LS404-123/STEAM/artifacts/mode2-motor-board/chip-inspection.png

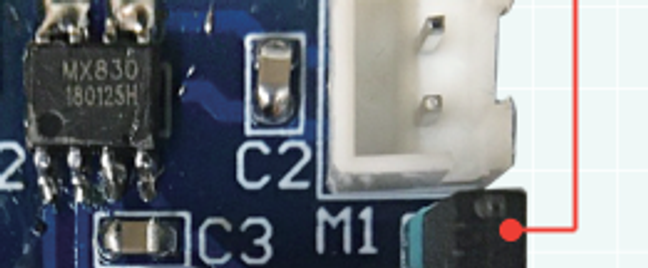
artifacts/mode2-motor-board/chip-inspection.png
