LS404-123/STEAM/artifacts/mode2-motor-board/kicad-rev-h/sources/S0-SS12D10G5-user.png

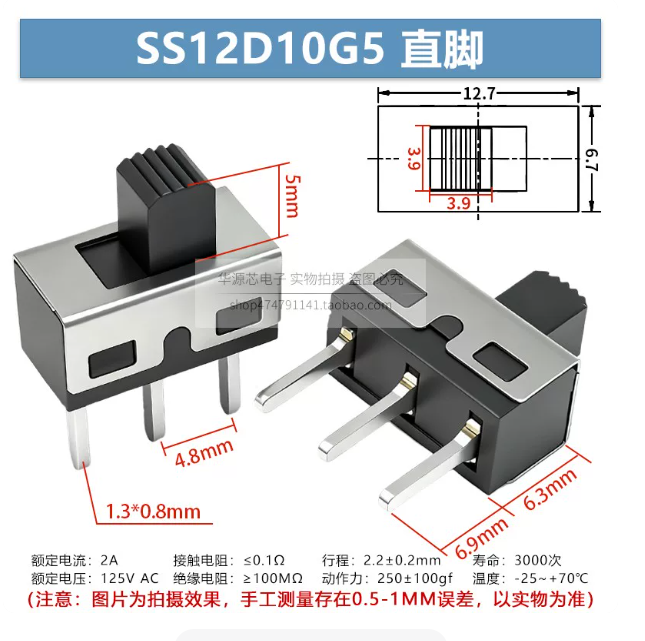
artifacts/mode2-motor-board/kicad-rev-h/sources/S0-SS12D10G5-user.png
