LS404-123/STEAM/artifacts/mode2-motor-board/kicad-rev-h/README.md

# 模式二 H 版：指定 SS12D10G5 直腳開關

依使用者提供的商品圖更換 G 版 S0。此為打樣設計，尚未實機測試。商品標示 **2A／125V AC**，直流馬達負載能力仍未驗證。

## 本次修改

- S0：SS12D10G5 直腳，3 腳、2 檔、單刀雙擲；非 D06 彎腳款。
- 本體依商品圖為 12.7 × 6.7 × 6.3 mm，柄高 5 mm；腳距由 4.70 改為 4.80 mm。
- 接腳截面 1.3 × 0.8 mm；PCB 採 1.85 mm 成品孔、2.60 mm 焊盤。
- 更新原理圖、S0 封裝、走線、3D 外形及 BOM；R／C 數值與控制邏輯沿用 G 版。
- 一塊 40 × 40 mm PCB，兩層銅線、1.6 mm 厚、22 個零件全部裝正面；無 Q1、LED、MCU 或模式跳線。

來源：sources/S0-SS12D10G5-user.png。商品圖註明手量誤差 0.5–1 mm；量產前須以樣品或原廠圖確認腳距、插入配合及接點方向。本封裝依標稱尺寸繪製。

S0 接線：1 接 BATT+、2 接 VCC、3 接 DISCH。接通 1–2 為開機，接通 2–3 為關機並透過 R6 放電。中腳為公共端的設計假設須實測；裝配前用萬用表確認左右撥向與 ON／OFF 絲印一致。直流負載、接觸壓降及溫升待測；圖片不能證明 150 件即時庫存。

## 接線及操作

零件面朝上、S0 在左上角：

| 接口 | 接法 |
|---|---|
| P1／BAT，右上 | 上孔負極，下孔正極；只接兩粒 AA 串聯 |
| P4／MOTOR，右側 | 上孔 M2，下孔 M1；方向相反時關機後交換兩線 |
| P2／SW1，左下 | 左孔 NO，右孔 COM |
| P3／SW2，下方 | 左孔 NO，右孔 COM |

微動開關使用 COM／NO，NC 不接。C8 是板外 100nF 陶瓷電容，直接跨接 FA-130 馬達兩端，不接 GND。接線前取出電池。

放開兩個開關後開機，馬達應保持停止。每次按下後放開，一次只按一個開關。

| 目前狀態 | 按 SW1 | 按 SW2 |
|---|---|---|
| 停止 | 正轉 | 保持停止 |
| 正轉 | 保持正轉 | 反轉 |
| 反轉 | 停止 | 保持反轉 |

沒有三秒鎖定；停止後放開再按 SW1 可重新啟動。同時按兩鍵的行為未定義。

## 檔案與 3D

- exports/原理圖-H.pdf：A3 可放大原理圖；同名網絡標籤表示相連。
- exports/模式二控制板H版使用手冊.pdf：接線、操作、邏輯、走線及原理圖；不含 R／C 計算。
- exports/PCB-3D.png、PCB正面.png、PCB背面.png：原生 KiCad 算繪圖，非實物照片。
- exports/pcb-traces-front.png、pcb-traces-back.png：走線圖；背面是板背視角。
- exports/完整3D板.wrl：含模型的 VRML，單位 mm；S0 等部分模型僅表達外形。
- fabrication/：與本版 PCB 對應的 Gerber 及鑽孔檔，供原型打樣，勿混用 G 版。

解壓完整專案，用 KiCad 10 開啟 mode2-no-firmware.kicad_pro，進入 PCB 編輯器，按 **Alt＋3** 看 3D。BoardF.pretty 是沿用的庫名稱；板上版本為 MODE 2 / H。

## 裝配與檢查

物料見 BOM.csv。U3 底部散熱焊盤必須焊接，適合交貼片店處理；S0 和四組端子從正面插入、背面焊接。C4 正極朝板下方，D1 色帶端朝左。

電源／馬達主幹 1.00 mm，一般訊號 0.25 mm，WSON 短引出線 0.20 mm；DRC 間距 0.20 mm。FR-4、40 × 40 mm、兩層、1.6 mm、1oz 銅，沒有安裝孔。

結果見 verification.json 和 reports/：原理圖接腳、PCB 一致性、漏接、間距、90° 銅線轉彎及指定邏輯模型檢查。這些檢查不能驗證開關額定或取代實機測試。兩粒 AA 在負載下須維持至少 2V；沒有額外固定 0.8A 限流。

## 重建

用 KiCad Python 依次執行 build_schematic.py、build_board.py、route_board.py，先執行 DRC 產生 reports/drc.json，再執行 finish_board.py 及 export_and_check.ps1。圖像及手冊從新版匯出檔重建，檢視後執行 package.py。模型與封裝隨包附上。
