LS404-123/STEAM/artifacts/mode2-motor-board/kicad-rev-h/reports/drill-report.txt

Drill report for mode2-no-firmware.kicad_pcb
Created on 2026-09-10T09:00:54

Copper Layer Stackup:
    =============================================================
    L1 :  F.Cu                      front
    L2 :  B.Cu                      back

Drill file 'mode2-no-firmware-PTH.drl' contains
    plated through holes:
    =============================================================
    T1  0.200mm  0.0079"  (2 holes))
    T2  0.300mm  0.0118"  (44 holes))
    T3  1.300mm  0.0512"  (8 holes))
    T4  1.850mm  0.0728"  (3 holes))

    Total plated holes count 57

Drill file 'mode2-no-firmware-NPTH.drl' contains
    unplated through holes:
    =============================================================

    Total unplated holes count 0
