LS404-123/STEAM/F1/202627年度中一IEE_徒手圖工作紙02.pdf

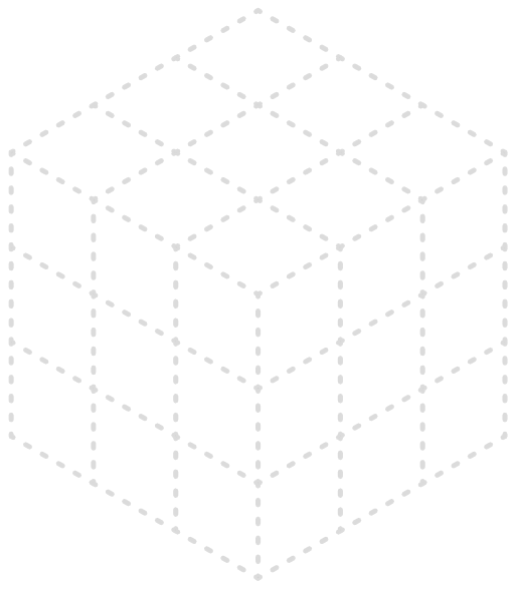
[picture p8: figure]

中一級 IEE 徒手圖 工作紙 03 P.1/4

## 佛教何南金中學

科目：IEE | | | 成績：
姓名： | （ ） | 班別： | 日期：

題目：徒手圖工作紙 02

把下列左方所示的圖形，依樣繪畫至右方的方格內。 | （40%）

圖 1.（3 分）

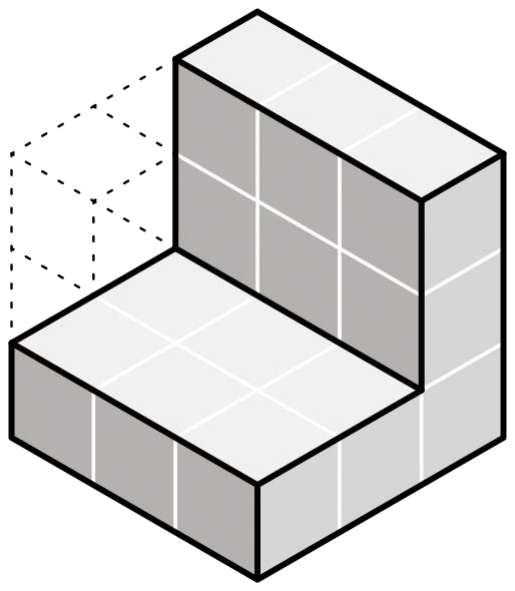
[picture p9: figure]
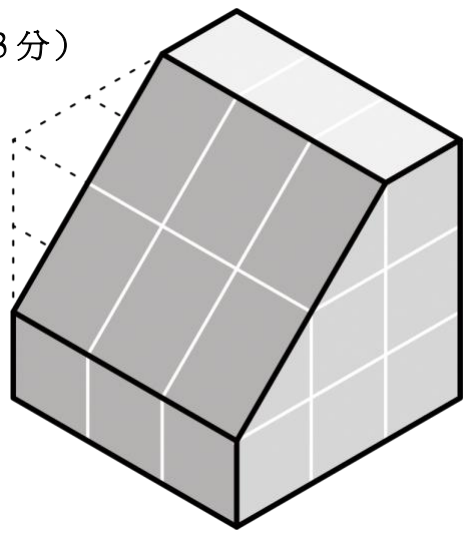
[picture p10: figure]

圖 2. （3 分）

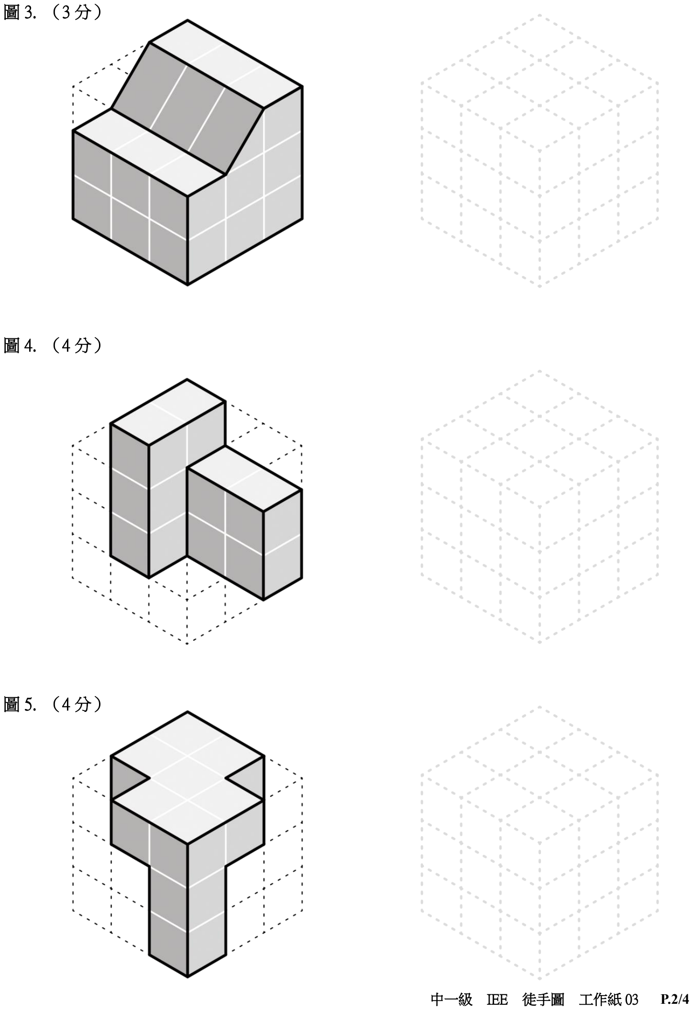
[picture p11: page 2]

圖 3. （3 分）

圖 4. （4 分）

圖 5. （4 分）

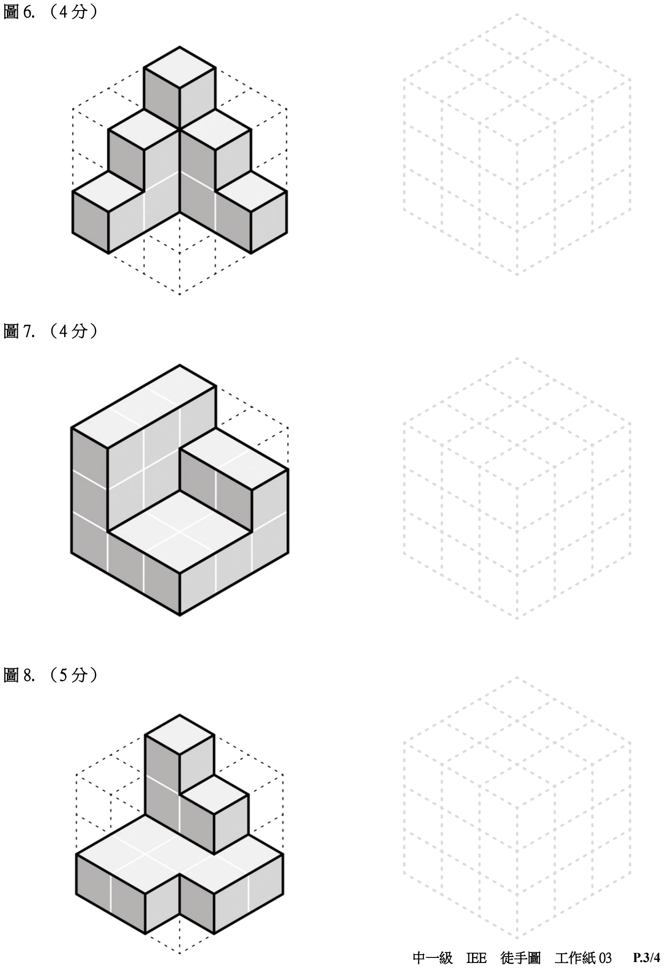
[picture p12: page 3]

圖 6. （4 分）

圖 7. （4 分）

圖 8. （5 分）

圖 9. （5 分）

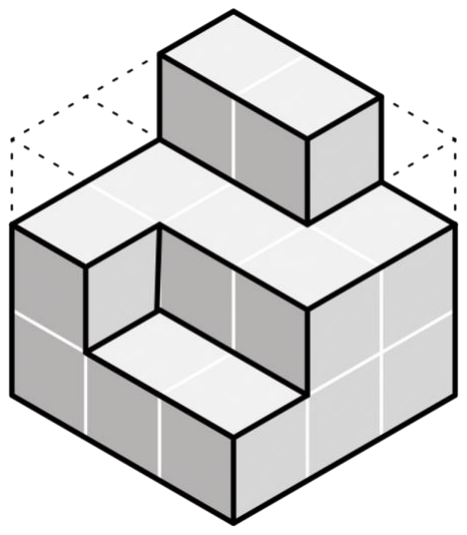
[picture p13: figure]

圖 10. （5 分）

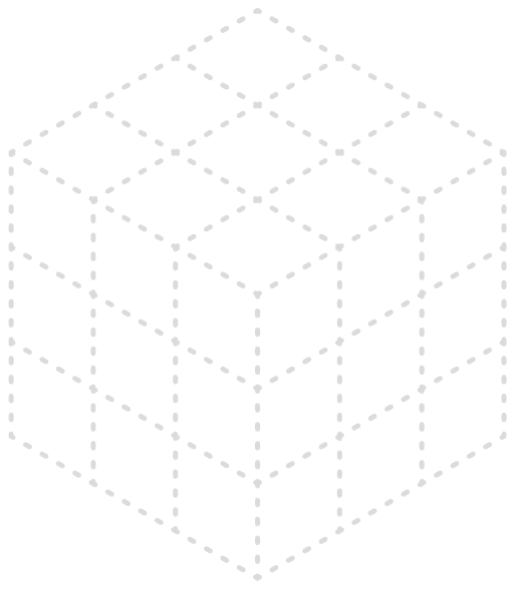
[picture p14: figure]
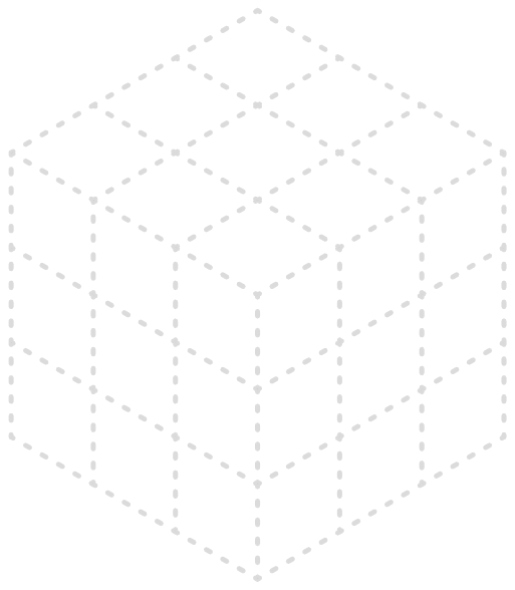
[picture p15: figure]
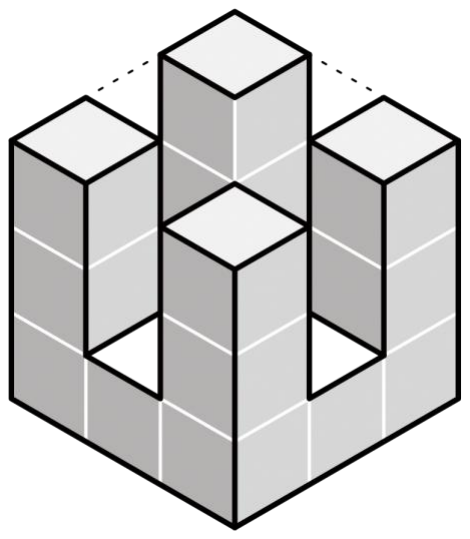
[picture p16: figure]

* * * 工 作 紙 完 * * *
