LS404-123/STEAM/artifacts/mode2-motor-board/chip-u1-inspection.png

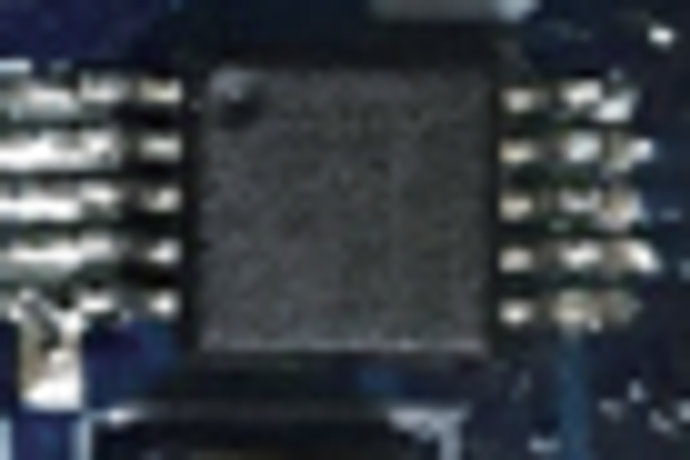
artifacts/mode2-motor-board/chip-u1-inspection.png
