LS404-123/STEAM/artifacts/mode2-motor-board/kicad-rev-h/exports/PCB-3D.png

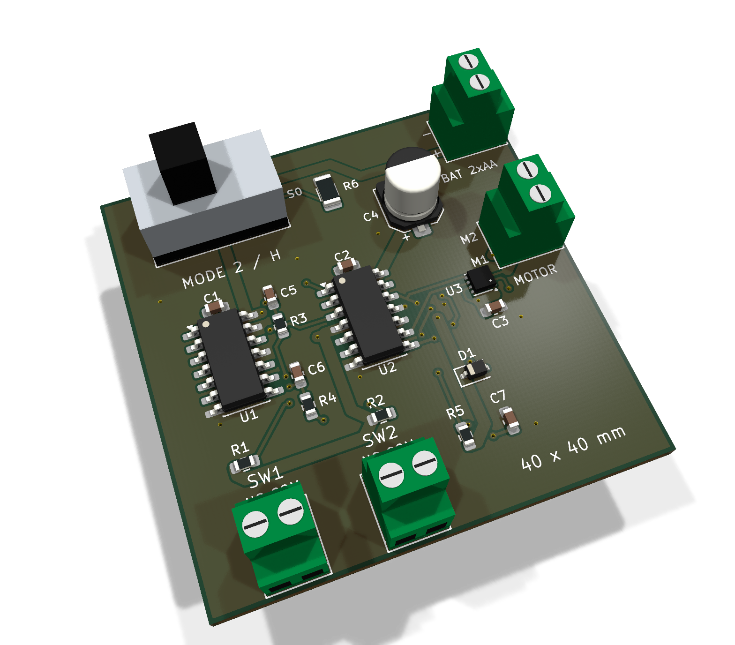
artifacts/mode2-motor-board/kicad-rev-h/exports/PCB-3D.png
