LS404-123/STEAM/artifacts/mode2-motor-board/kicad-rev-h/exports/PCB背面.png

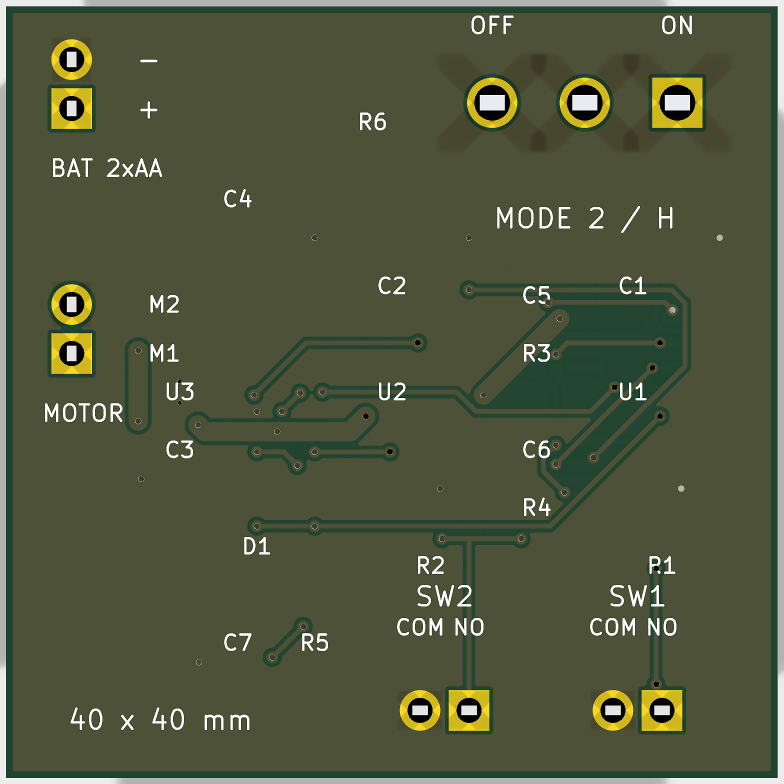
artifacts/mode2-motor-board/kicad-rev-h/exports/PCB背面.png
