LS404-123/STEAM/F1/worksheet-model-01.png

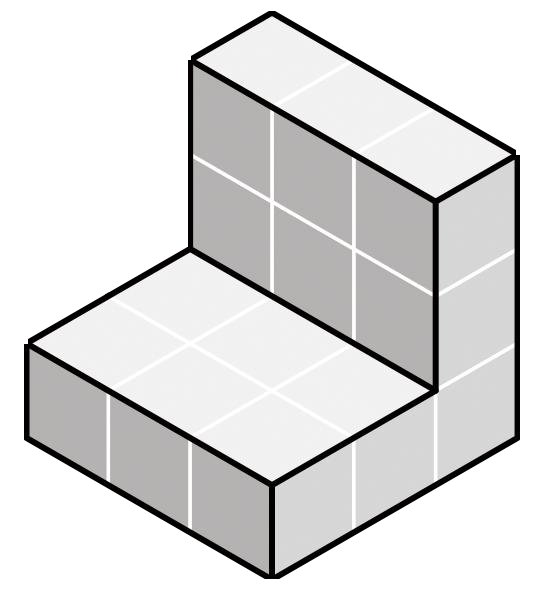
F1/worksheet-model-01.png
