LS404-123/STEAM/F1/worksheet-model-02.png

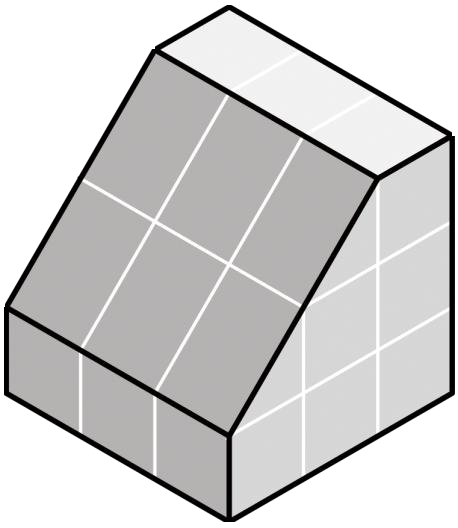
F1/worksheet-model-02.png
