LS404-123/STEAM/F1/worksheet-model-03.png

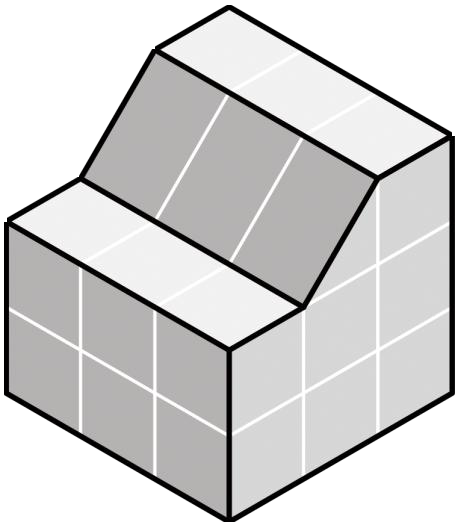
F1/worksheet-model-03.png
