LS404-123/STEAM/F1/worksheet-model-04.png

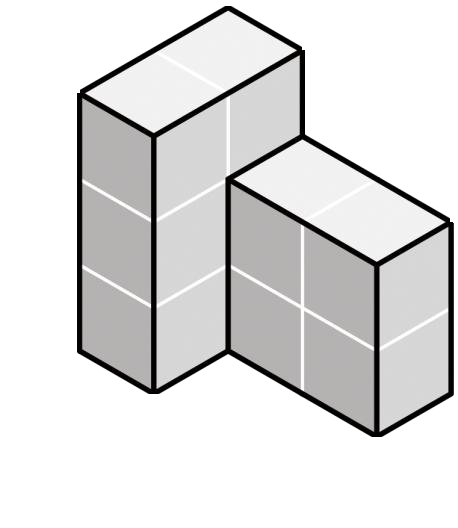
F1/worksheet-model-04.png
