LS404-123/STEAM/F1/worksheet-model-05.png

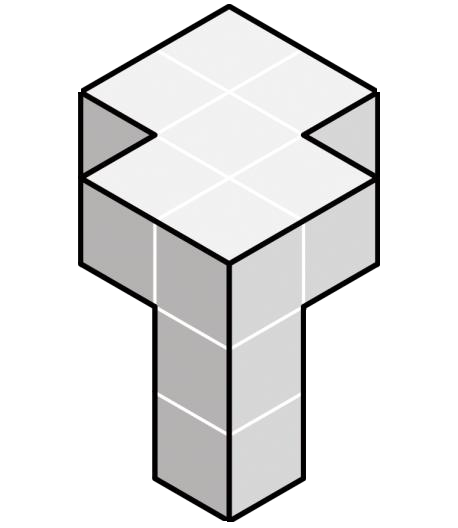
F1/worksheet-model-05.png
