LS404-123/STEAM/F1/worksheet-model-06.png

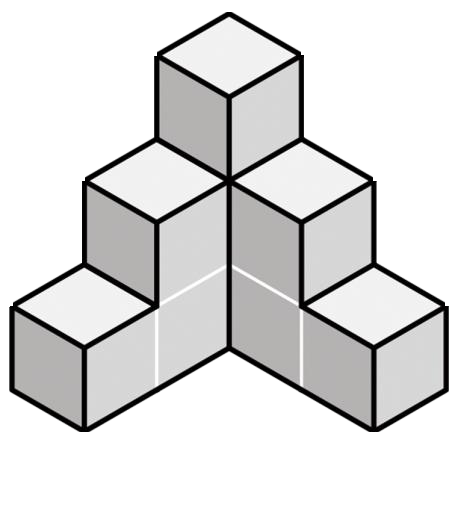
F1/worksheet-model-06.png
