LS404-123/STEAM/F1/worksheet-model-07.png

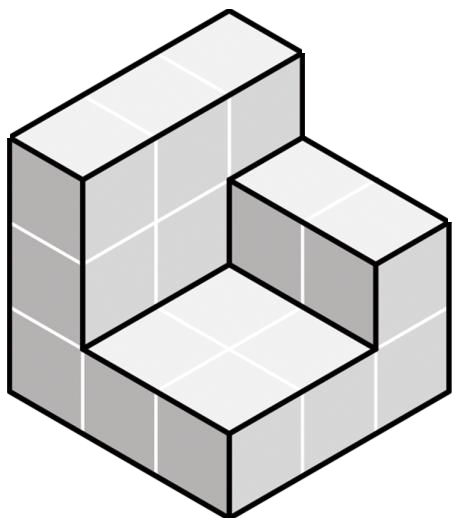
F1/worksheet-model-07.png
