LS404-123/STEAM/F1/worksheet-model-08.png

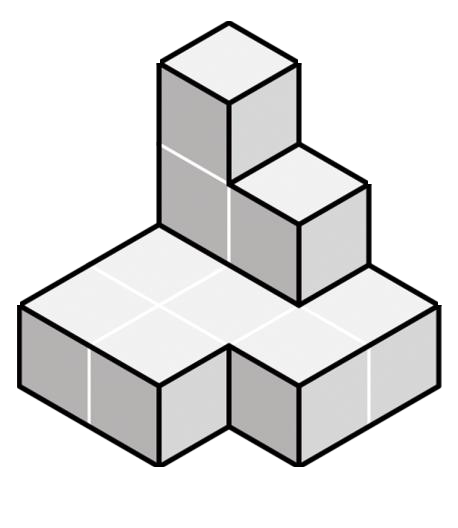
F1/worksheet-model-08.png
