LS404-123/STEAM/F1/worksheet-model-09.png

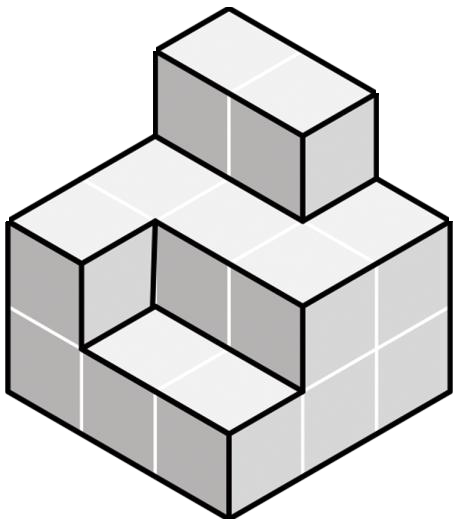
F1/worksheet-model-09.png
