LS404-123/STEAM/artifacts/mode2-motor-board/kicad-rev-h/models/D_SOD-323.step

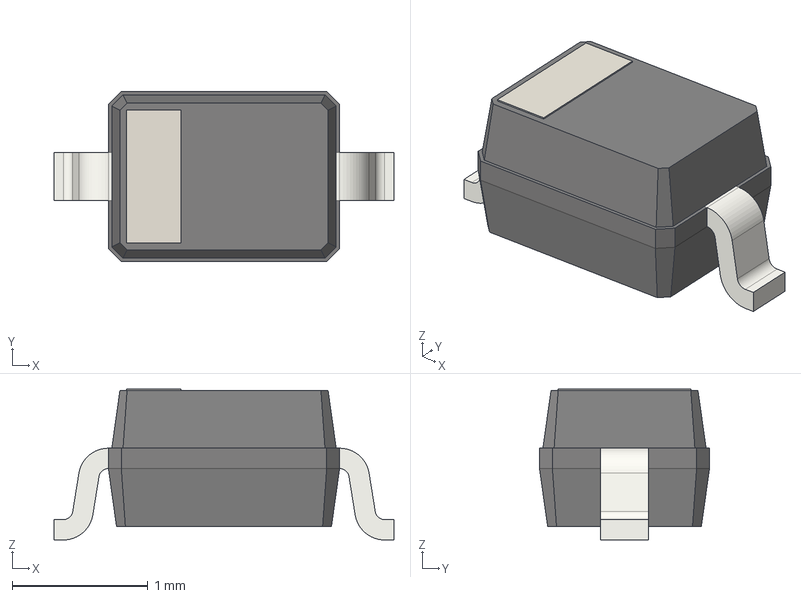
[picture p35: CAD file, 2026-09-09]
artifacts/mode2-motor-board/kicad-rev-h/models/D_SOD-323.step
2.50 x 1.25 x 1.11 mm
