LS404-123/STEAM/artifacts/mode2-motor-board/kicad-rev-h/models/SOT-23.step

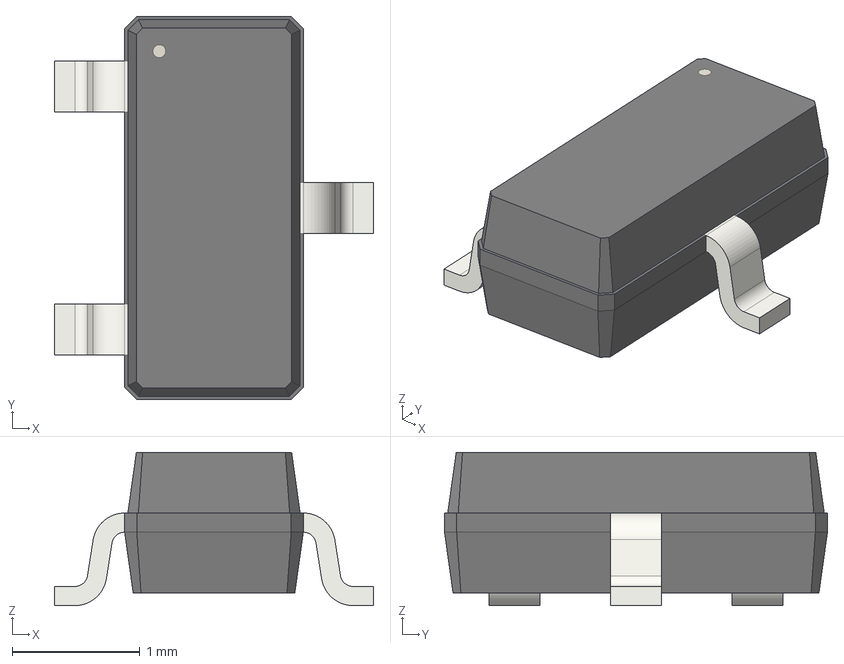
[picture p36: CAD file, 2026-09-09]
artifacts/mode2-motor-board/kicad-rev-h/models/SOT-23.step
2.50 x 3.00 x 1.20 mm
