LS404-123/STEAM/artifacts/mode2-motor-board/kicad-rev-h/models/SOIC-14_3.9x8.7mm_P1.27mm.step

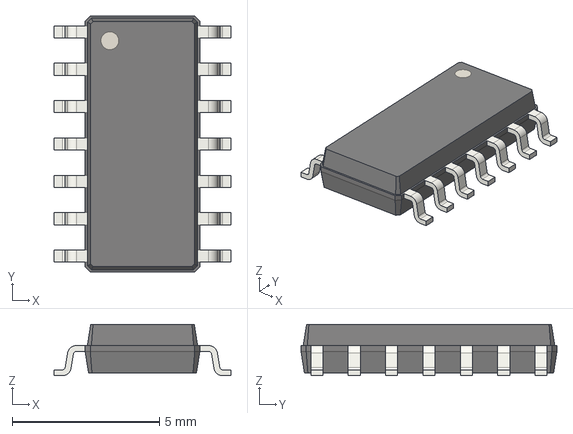
[picture p37: CAD file, 2026-09-09]
artifacts/mode2-motor-board/kicad-rev-h/models/SOIC-14_3.9x8.7mm_P1.27mm.step
6.00 x 8.70 x 1.75 mm
