LS404-123/STEAM/artifacts/mode2-motor-board/kicad-rev-h/models/C_0603_1608Metric.step

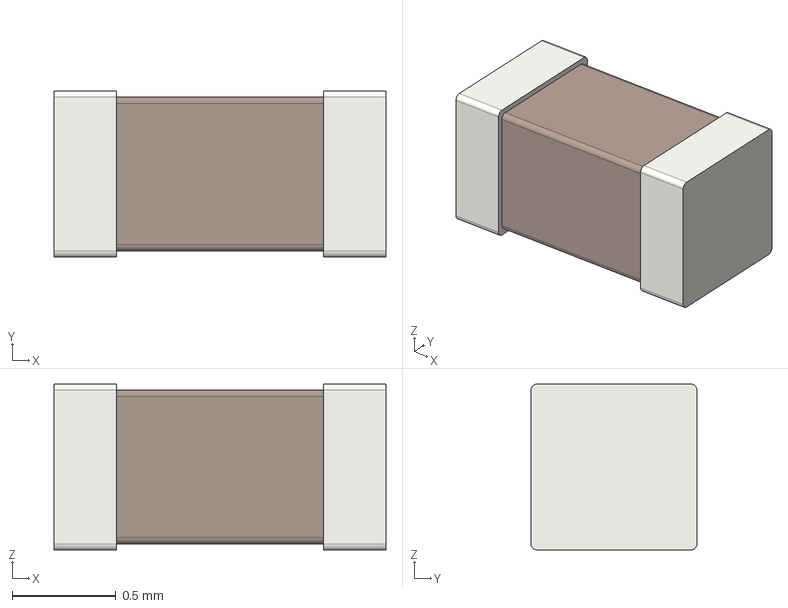
[picture p39: CAD file, 2026-09-09]
artifacts/mode2-motor-board/kicad-rev-h/models/C_0603_1608Metric.step
1.60 x 0.8 x 0.8 mm
