LS404-123/STEAM/artifacts/mode2-motor-board/kicad-rev-h/models/R_1206_3216Metric.step

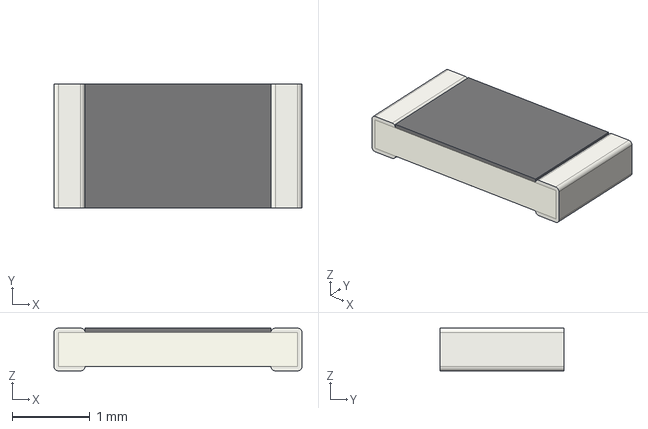
[picture p40: CAD file, 2026-09-09]
artifacts/mode2-motor-board/kicad-rev-h/models/R_1206_3216Metric.step
3.20 x 1.60 x 0.55 mm
