LS404-123/STEAM/artifacts/mode2-motor-board/kicad-rev-h/models/CP_Elec_5x5.8.step

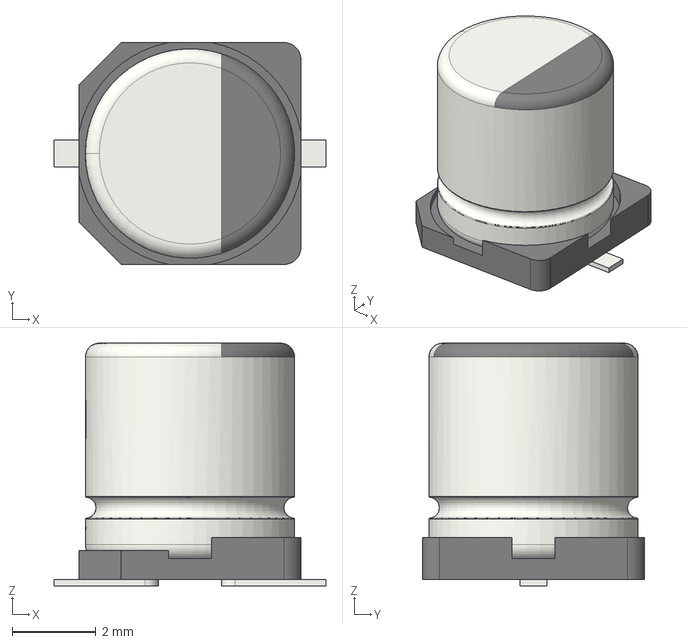
[picture p41: CAD file, 2026-09-09]
artifacts/mode2-motor-board/kicad-rev-h/models/CP_Elec_5x5.8.step
6.50 x 5.30 x 5.80 mm
