LS404-123/STEAM/artifacts/mode2-motor-board/kicad-rev-h/models/SOIC-8_3.9x4.9mm_P1.27mm.step

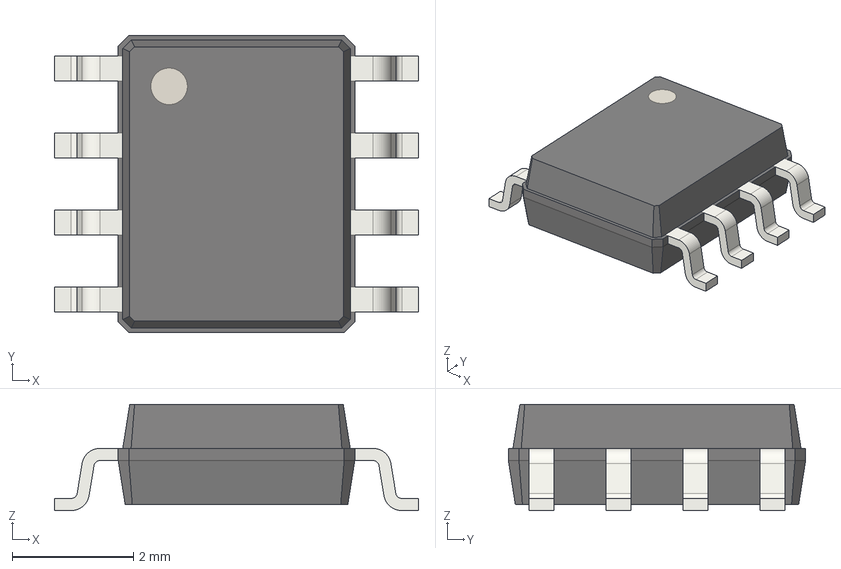
[picture p42: CAD file, 2026-09-09]
artifacts/mode2-motor-board/kicad-rev-h/models/SOIC-8_3.9x4.9mm_P1.27mm.step
6.00 x 4.90 x 1.75 mm
