LS404-123/STEAM/artifacts/mode2-motor-board/kicad-rev-h/reports/manual-qa/page-1.png

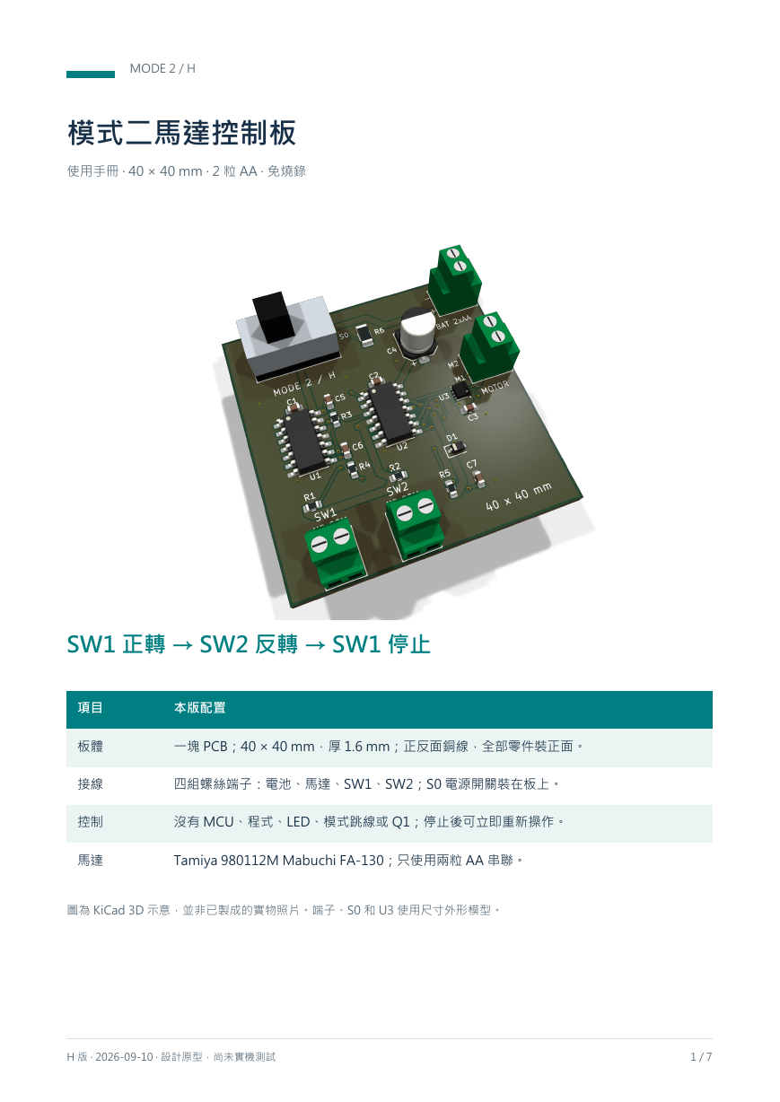
artifacts/mode2-motor-board/kicad-rev-h/reports/manual-qa/page-1.png
