LS404-123/STEAM/artifacts/mode2-motor-board/kicad-rev-h/reports/manual-qa/page-2.png

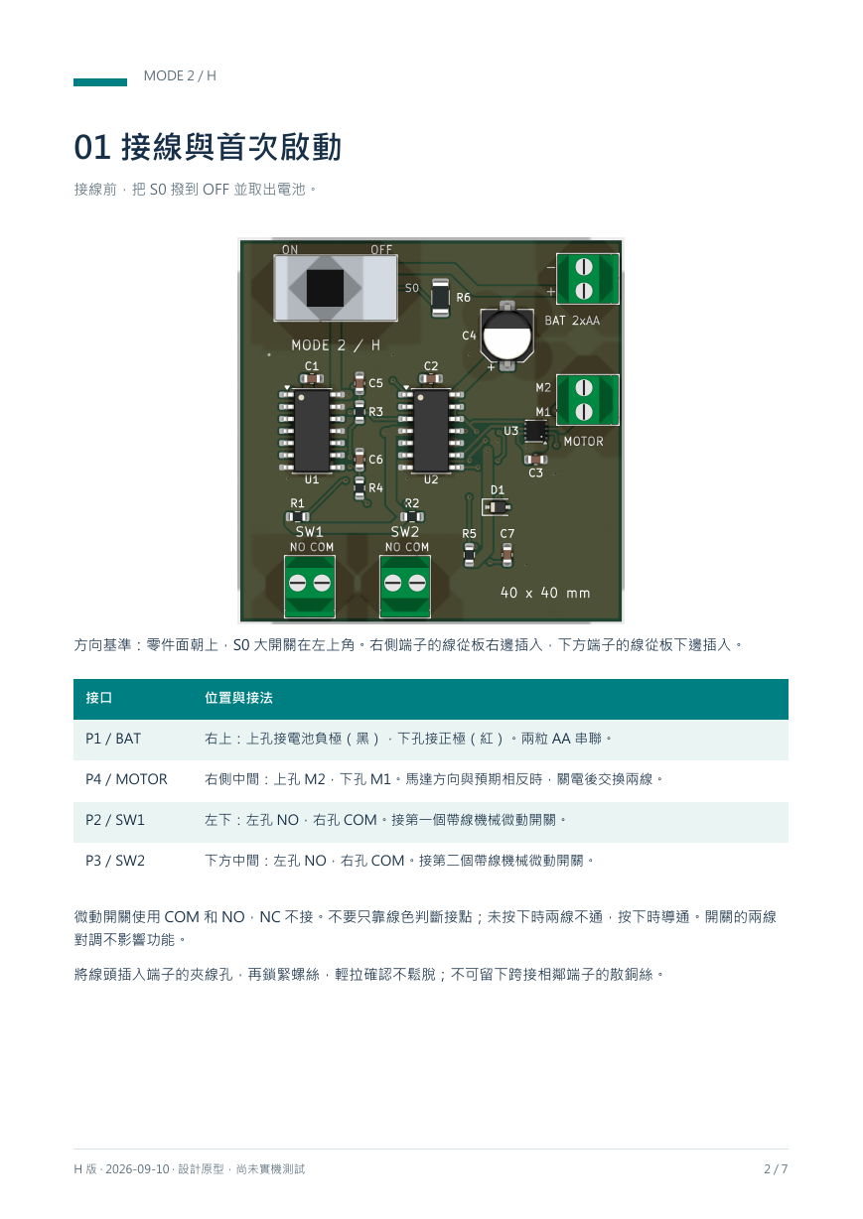
artifacts/mode2-motor-board/kicad-rev-h/reports/manual-qa/page-2.png
