LS404-123/STEAM/artifacts/mode2-motor-board/kicad-rev-h/mode2-no-firmware.kicad_pcb

## KiCad design artifacts/mode2-motor-board/kicad-rev-h/mode2-no-firmware.kicad_pcb (2026-09-10)

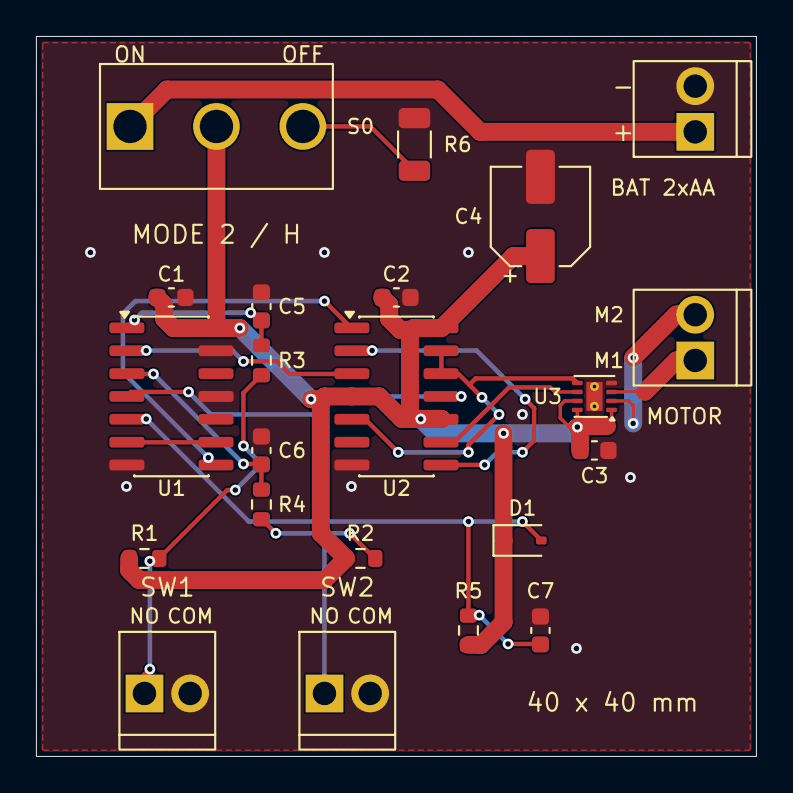
[picture p49: board mode2-no-firmware.kicad_pcb from above]

Board: 2 copper layers, 40.0 x 40.0 mm, 22 parts (0 on the bottom side), 18 nets.

Parts:
C1, C2, C3: 100nF / 16V; C0603
C4: 100uF / 6.3V; CP5
C5, C6: 220nF; C0603
C7: 100nF; C0603
D1: BAT54WS; SOD323
P1: 電池螺絲端子; KF128_2P
P2: SW1 螺絲端子; KF128_2P
P3: SW2 螺絲端子; KF128_2P
P4: 馬達螺絲端子; KF128_2P
R1, R2, R5: 100k; R0603
R3, R4: 1k; R0603
R6: 100R / 0.25W; R1206
S0: SS12D10G5
U1: SN74HC14DR; SOIC14
U2: SN74HC74DR; SOIC14
U3: DRV8212DSGR; WSON8

Connections:
/BATT+: P1.1, S0.1
/CLK1: U1.2, U2.3
/CLK2: U1.4, U2.11
/DB1: C5.1, R3.2, U1.1
/DB2: C6.1, R4.2, U1.3
/DISCH: R6.1, S0.3
/GND: C1.2, C2.2, C3.2, C4.2, C5.2, C6.2, C7.2, P1.2, P2.2, P3.2, R6.2, U1.7, U1.11, U1.13, U2.7, U3.4, U3.9
/M1: P4.1, U3.3
/M2: P4.2, U3.2
/NOT_REV: U2.2, U2.8
/POR_INV: U1.6, U1.9
/POR_RC: C7.1, D1.2, R5.2, U1.5
/RESET_N: U1.8, U2.1
/REV: U2.9, U3.6
/RUN: U2.5, U2.12, U2.13, U3.5
/SW1: P2.1, R1.2, R3.1
/SW2: P3.1, R2.2, R4.1
/VCC: C1.1, C2.1, C3.1, C4.1, D1.1, R1.1, R2.1, R5.1, S0.2, U1.14, U2.4, U2.10, U2.14, U3.1, U3.7, U3.8
