LS404-123/STEAM/(commit log)

2026-03-15 feat: Implement dynamic grid sizing and add modal tabs for filtering sample patterns by color group.
2026-04-09 change the index.html to 3*3 LED board animation
2026-04-10 update a new LED arrangement in 5*5
2026-04-10 update color of current and some bug
2026-09-07 feat: redesign STEAM laboratory landing page
2026-09-07 fix: enlarge frame bracing diagrams and tighten panel spacing
2026-09-08 refactor: optimize bridge solver and frame scheduling
2026-09-09 feat: visualize axial tension and compression forces
    [500ASSPxM2xE.stp, BOM.csv, CP_Elec_5x5.8.step, C_0603_1608Metric.step, D_SOD-323.step, JST_PH_B2B-PH-K_1x02_P2.00mm_Vertical.step, JST_XH_B2B-XH-A_1x02_P2.50mm_Vertical.step, R_0603_1608Metric.step]
2026-09-10 feat: automatically glue touching bridge bars
    [BOM.csv, CP_Elec_5x5.8.step, C_0603_1608Metric.step, D_SOD-323.step, R_0603_1608Metric.step, R_1206_3216Metric.step, SOIC-14_3.9x8.7mm_P1.27mm.step, SOIC-8_3.9x4.9mm_P1.27mm.step]
2026-09-10 chore: remove 378 obsolete project files
    [500ASSPxM2xE.stp, BOM.csv, CP_Elec_5x5.8.step, C_0603_1608Metric.step, JST_PH_B2B-PH-K_1x02_P2.00mm_Vertical.step, JST_XH_B2B-XH-A_1x02_P2.50mm_Vertical.step, R_0603_1608Metric.step, SOIC-8_3.9x4.9mm_P1.27mm.step]
2026-09-22 feat: allow glued bridge joints to reshape during editing
