LS404-123/STEAM/(notices)

Notices in the files:
artifacts/mode2-motor-board/kicad-rev-h/models/R_0603_1608Metric.step:
Copyright (C) 2018, kicad StepUp
This work is licensed under the [Creative Commons CC-BY-SA 4.0 License](https://creativecommons.org/licenses/by-sa/4.0/legalcode),
with the following exception:
To the extent that the creation of electronic designs that use 'Licensed Material' can be considered to be 'Adapted Material',
You are free to use the library data in your own projects without the obligation to share your project files under this or any other license agreement.
artifacts/mode2-motor-board/kicad-rev-h/models/C_0603_1608Metric.step:
Copyright (C) 2017, kicad StepUp
artifacts/mode2-motor-board/kicad-rev-h/models/SOIC-14_3.9x8.7mm_P1.27mm.step:
Copyright (C) 2025, KiCAD
This work is licensed under the
[Creative Commons CC-BY-SA 4.0 License](https://creativecommons.org/licenses/by-sa/4.0/legalcode),
project files under this or any other license agreement. However, if you wish to distribute
